ProjectSwift/swift/Eagle Files/SwiftV2.brd

## EAGLE design Eagle Files/SwiftV2.brd (2012-04-03)

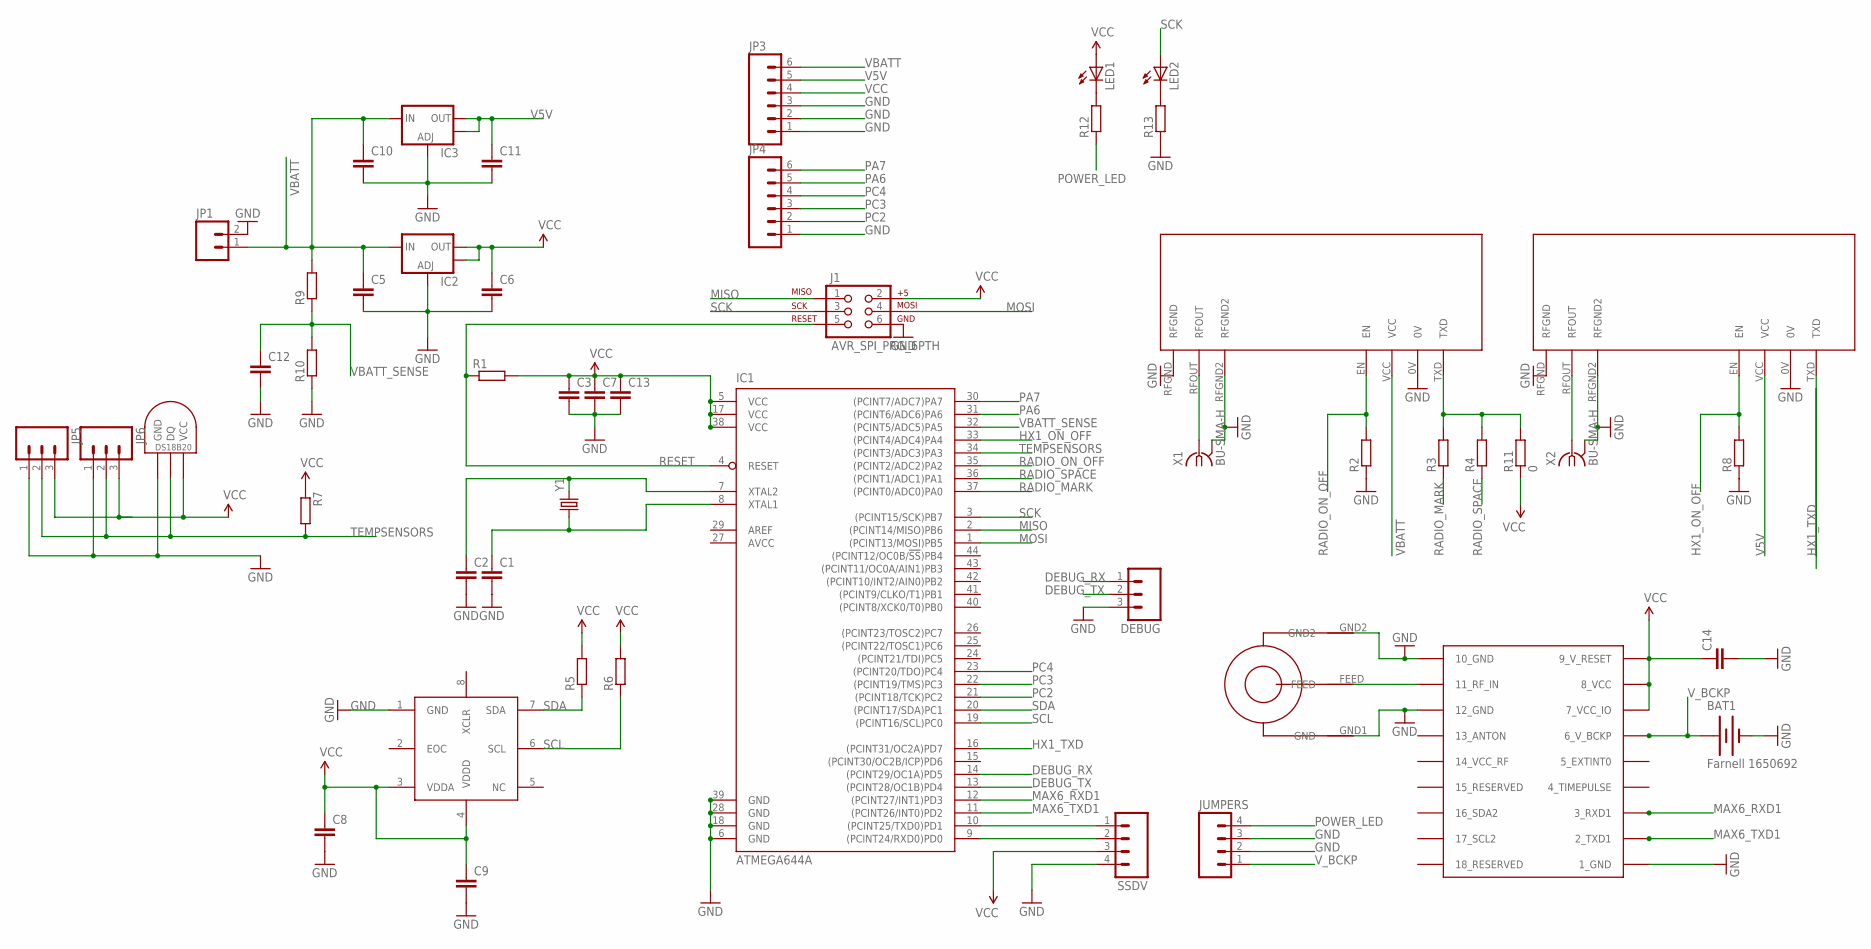
[picture p1: schematic SwiftV2.sch]

Parts:
BAT1: Farnell 1650692; BATTCON_12MM
C1, C2, C3, C5, C6, C7, C8, C9, C10, C11, C12, C13, C14: C-EUC0805; C0805
DEBUG: M03PTH; 1X03
IC1: ATMEGA644A; TQFP44
IC2, IC3: V_REG_LM1117SOT223; SOT223
J1: AVR_SPI_PRG_6PTH; 2X3
JP1: M02JST-PTH-2; JST-2-PTH
JP3, JP4: M06SIP; 1X06
JP5, JP6: M03JST-PTH; JST-3-PTH
JUMPERS: M04PTH; 1X04
LED1, LED2: LED0603; LED-0603
R1, R2, R3, R4, R5, R6, R7, R8, R9, R10, R12, R13: R-EU_R0805; R0805
R11: 0; R0805
SSDV: M04PTH; 1X04
TEMPINT: DS1821; DS18B20_SOIC
U$1: BMP085
U$2: NTX2
U$3: SARANTEL-SR1202
U$4: UBLOX_MAX-6
U$5: RADIOMETRIX-HX1
X1, X2: BU-SMA-H
Y1: CRYSTALSMD; HC49UP

Connections:
AVCC: IC1.27 (AVCC)
DEBUG_RX: DEBUG.1, IC1.14 ((PCINT29/OC1A)PD5)
DEBUG_TX: DEBUG.2, IC1.13 ((PCINT28/OC1B)PD4)
GND: BAT1.GND (-), C1.2, C2.2, C3.2, C5.2, C6.2, C7.2, C8.2, C9.2, C10.2, C11.2, C12.2, C13.2, C14.2, DEBUG.3, IC1.6 (GND), IC1.18 (GND), IC1.28 (GND), IC1.39 (GND), IC2.1 (ADJ), IC3.1 (ADJ), J1.6, JP1.2, JP3.1, JP3.2, JP3.3, JP4.1, JP5.1, JP6.1, JUMPERS.2, JUMPERS.3, R2.1, R8.1, R10.1, R13.1, SSDV.4, TEMPINT.GND, U$1.1 (GND), U$2.0V, U$2.RFGND, U$2.RFGND2, U$3.GND1 (GND), U$3.GND2, U$4.1_GND, U$4.10_GND, U$4.12_GND, U$5.0V, U$5.RFGND, U$5.RFGND2, X1.2 (GND), X1.3 (GND), X1.4 (GND), X1.5 (GND), X2.2 (GND), X2.3 (GND), X2.4 (GND), X2.5 (GND)
HX1_ON_OFF: IC1.33 ((PCINT4/ADC4)PA4), R8.2, U$5.EN
HX1_TXD: IC1.16 ((PCINT31/OC2A)PD7), U$5.TXD
MAX6_RXD1: IC1.12 ((PCINT27/INT1)PD3), U$4.3_RXD1
MAX6_TXD1: IC1.11 ((PCINT26/INT0)PD2), U$4.2_TXD1
MISO: IC1.2 ((PCINT14/MISO)PB6), J1.1
MOSI: IC1.1 ((PCINT13/MOSI)PB5), J1.4
unnamed: C2.1, IC1.7 (XTAL2), Y1.2
unnamed: C1.1, IC1.8 (XTAL1), Y1.1
unnamed: U$2.RFOUT, X1.1
unnamed: LED1.C, R12.2
unnamed: U$5.RFOUT, X2.1
unnamed: U$3.FEED, U$4.11_RF_IN
unnamed: R3.2, R4.2, R11.2, U$2.TXD
unnamed: LED2.C, R13.2
PA6: IC1.31 ((PCINT6/ADC6)PA6), JP4.5
PA7: IC1.30 ((PCINT7/ADC7)PA7), JP4.6
PC2: IC1.21 ((PCINT18/TCK)PC2), JP4.2
PC3: IC1.22 ((PCINT19/TMS)PC3), JP4.3
PC4: IC1.23 ((PCINT20/TDO)PC4), JP4.4
POWER_LED: JUMPERS.4, R12.1
RADIO_MARK: IC1.37 ((PCINT0/ADC0)PA0), R3.1
RADIO_ON_OFF: IC1.35 ((PCINT2/ADC2)PA2), R2.2, U$2.EN
RADIO_SPACE: IC1.36 ((PCINT1/ADC1)PA1), R4.1
RESET: IC1.4 (RESET), J1.5, R1.1
RXD0: IC1.9 ((PCINT24/RXD0)PD0), SSDV.2
SCK: IC1.3 ((PCINT15/SCK)PB7), J1.3, LED2.A
SCL: IC1.19 ((PCINT16/SCL)PC0), R6.1, U$1.6 (SCL)
SDA: IC1.20 ((PCINT17/SDA)PC1), R5.1, U$1.7 (SDA)
TEMPSENSORS: IC1.34 ((PCINT3/ADC3)PA3), JP5.2, JP6.2, R7.2, TEMPINT.DQ
TXD0: IC1.10 ((PCINT25/TXD0)PD1), SSDV.1
V5V: C11.1, IC3.2 (OUT), IC3.4 (OUT), JP3.5, U$5.VCC
VBATT: C5.1, C10.1, IC2.3 (IN), IC3.3 (IN), JP1.1, JP3.6, R9.2, U$2.VCC
VBATT_SENSE: C12.1, IC1.32 ((PCINT5/ADC5)PA5), R9.1, R10.2
VCC: C3.1, C6.1, C7.1, C8.1, C9.1, C13.1, C14.1, IC1.5 (VCC), IC1.17 (VCC), IC1.38 (VCC), IC2.2 (OUT), IC2.4 (OUT), J1.2, JP3.4, JP5.3, JP6.3, LED1.A, R1.2, R5.2, R6.2, R7.1, R11.1, SSDV.3, TEMPINT.VCC, U$1.3 (VDDA), U$1.4 (VDDD), U$4.7_VCC_IO, U$4.8_VCC, U$4.9_V_RESET
V_BCKP: BAT1.PWR@1 (+), JUMPERS.1, U$4.6_V_BCKP

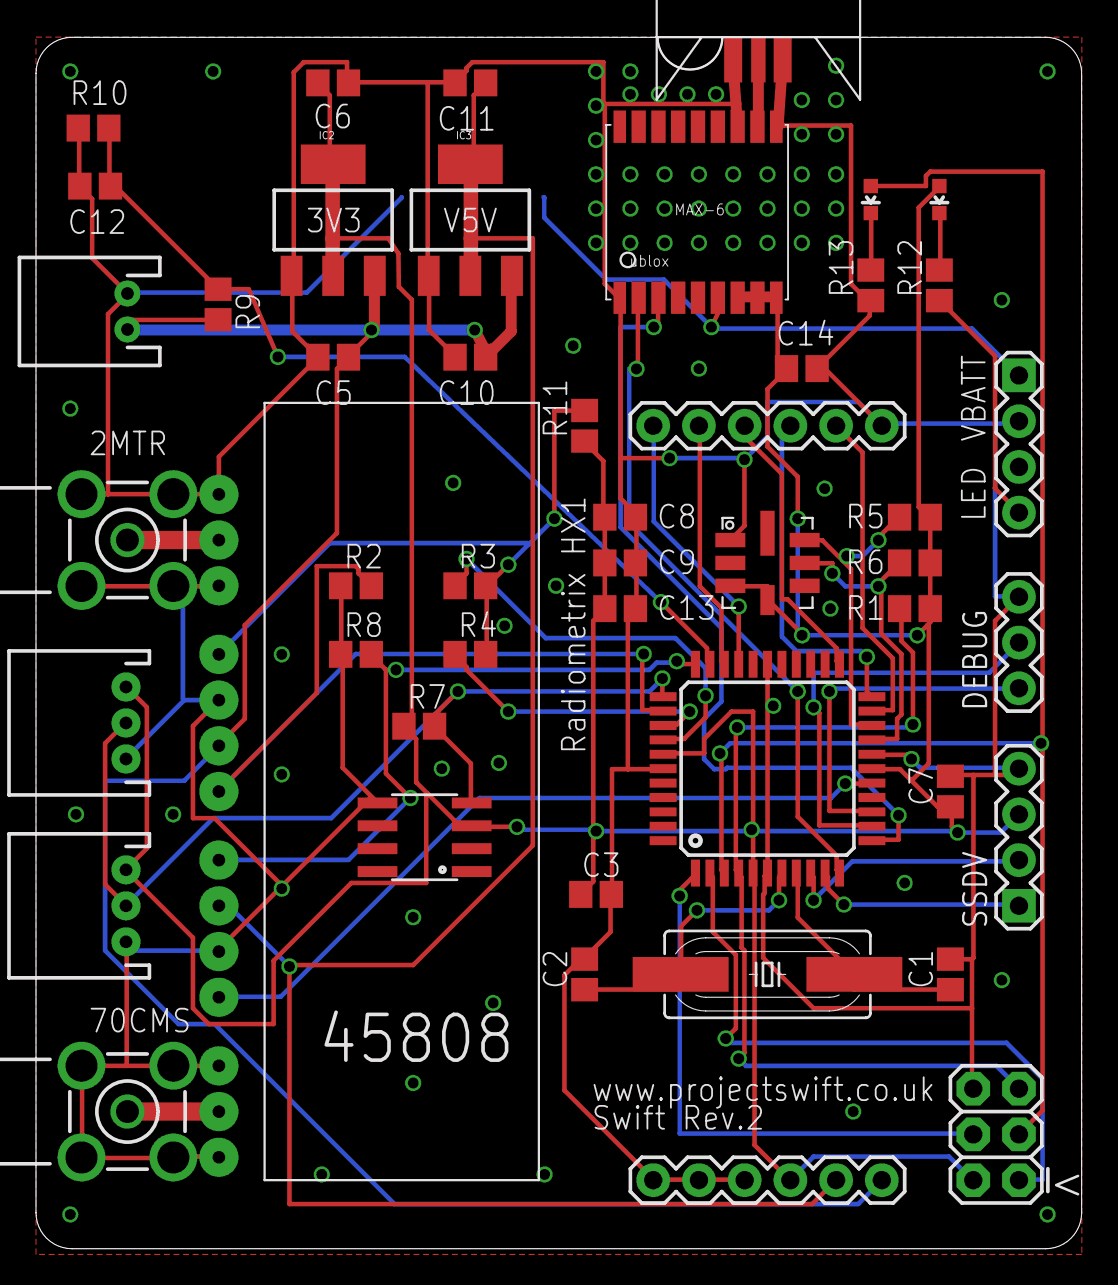
[picture p2: board SwiftV2.brd from above]

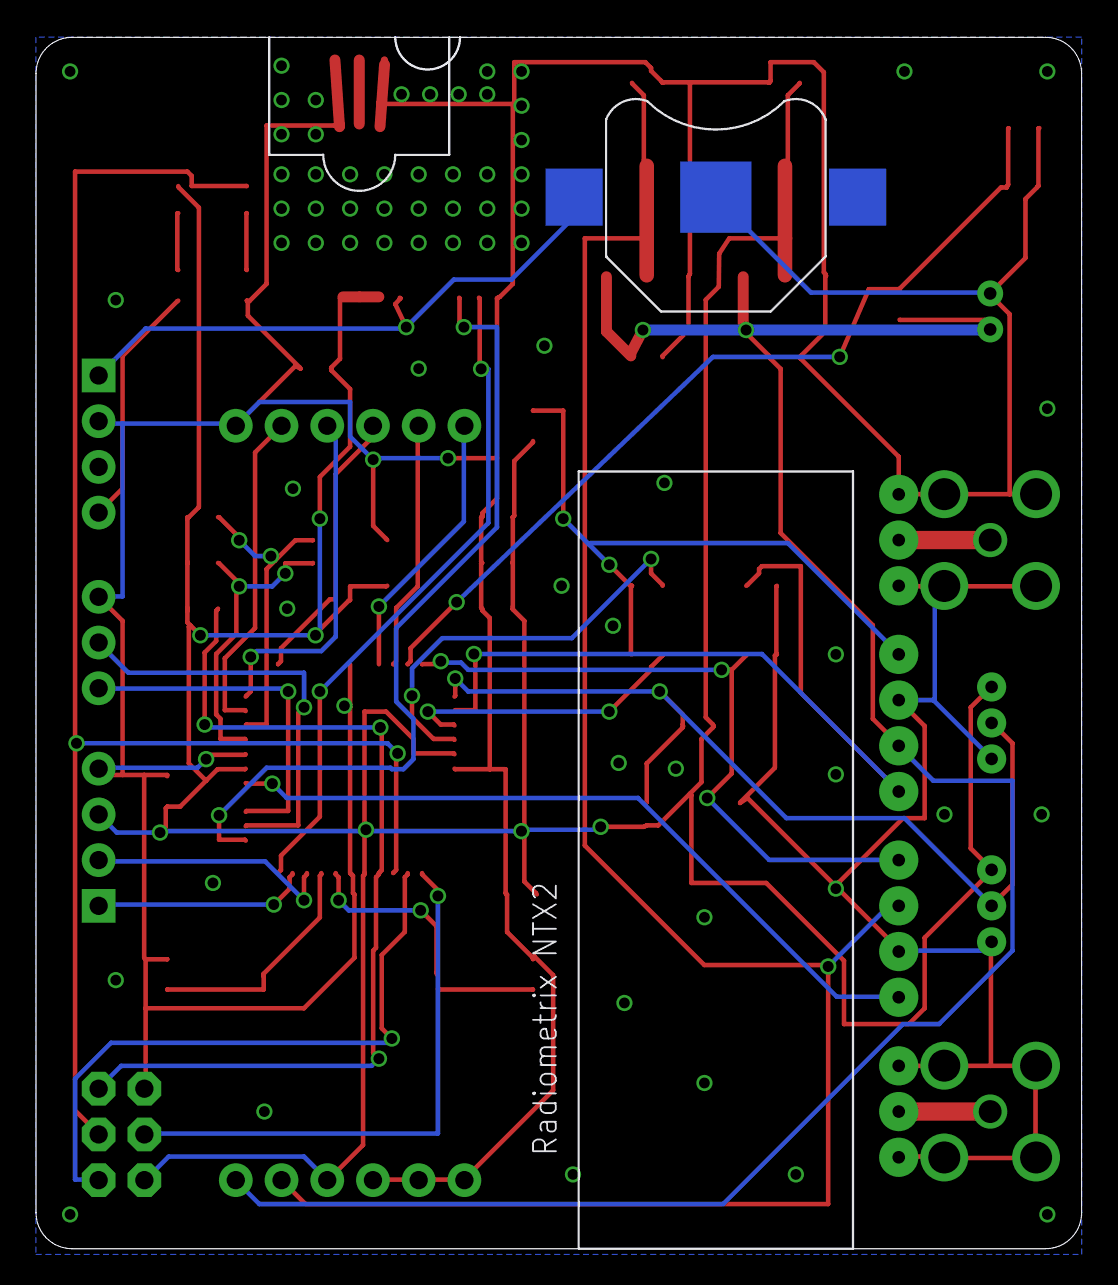
[picture p3: board SwiftV2.brd from below]

Board: 2 copper layers, 58.1 x 67.3 mm, 50 parts (2 on the bottom side), 38 nets.
