ProjectSwift/swift/config.h

#ifndef _CONFIG_H
#define _CONFIG_H

#define F_CPU (8000000)

//#define APRS_ENABLED
#define APRS_CALLSIGN "NOCALL"
#define APRS_SSID     (0)

#define RTTY_CALLSIGN "SWIFT"
#define RTTY_BAUD (300)

//#define SSDV_ENABLED

#endif
