ProjectSwift/swift/geofence.c

/* Project Swift - High altitude balloon flight software                 */
/*=======================================================================*/
/* Copyright 2010-2012 Nigel Smart <nigel@projectswift.co.uk>            */
/* And Philip Heron <phil@sanslogic.co.uk>                               */
/* Additional Help from Jon Sowman & Adam Greig of Cambridge University  */
/* Spaceflight (www.cusf.co.uk)                                          */
/*                                                                       */
/* This program is free software: you can redistribute it and/or modify  */
/* it under the terms of the GNU General Public License as published by  */
/* the Free Software Foundation, either version 3 of the License, or     */
/* (at your option) any later version.                                   */
/*                                                                       */
/* This program is distributed in the hope that it will be useful,       */
/* but WITHOUT ANY WARRANTY; without even the implied warranty of        */
/* MERCHANTABILITY or FITNESS FOR A PARTICULAR PURPOSE. See the          */
/* GNU General Public License for more details.                          */
/*                                                                       */
/* You should have received a copy of the GNU General Public License     */
/* along with this program. If not, see <http://www.gnu.org/licenses/>.  */

#include <stdint.h>
#include <avr/pgmspace.h>

/* The geofence array contains an outline of the area where
 * APRS usage is not permitted */

PROGMEM static const int32_t const geofence[50 * 2] =
{
	489924043, -36103603,
	488138903, -22610257,
	491901282, -13252978,
	496351217, -10050508,
	501037998,  11279993,
	507722758,  16260619,
	513189809,  25152367,
	520765597,  35119373,
	530454023,  42970152,
	539001634,  49909694,
	546830552,  44727668,
	551230292,  34601012,
	554336032,  29904906,
	558418741,  26487290,
	566806014,  24488896,
	575931754,  16723936,
	584164868,  11759240,
	589641150,   4293681,
	601679345,  -5502415,
	602106803, -22911888,
	598068675, -31797350,
	594741753, -52432139,
	590767750,-112927263,
	586042329,-125682437,
	573560679,-123463450,
	568484965,-110679665,
	567960819, -94029714,
	565955176, -84036460,
	562488969, -74621136,
	558888574, -68508447,
	554623831, -62193300,
	554506766, -75560492,
	552283624, -86434228,
	546950633, -86430795,
	539200807, -75704420,
	538233232, -70009827,
	537741074, -59159398,
	534700525, -58290520,
	532493620, -58085376,
	529591630, -58389442,
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
};

static int pointinpoly(const int32_t *poly, int points, int32_t x, int32_t y)
{
	int32_t p0, p1, l0, l1;
	int c = 0;
	
	/* Read the final point */
	p0 = pgm_read_dword(&poly[points * 2 - 2]);
	p1 = pgm_read_dword(&poly[points * 2 - 1]);
	
	for(; points; points--, poly += 2)
	{
		l0 = p0;
		l1 = p1;
		p0 = pgm_read_dword(&poly[0]);
		p1 = pgm_read_dword(&poly[1]);
		
		if(y < p1 && y < l1) continue;
		if(y >= p1 && y >= l1) continue;
		if(x < p0 + (l0 - p0) * (y - p1) / (l1 - p1)) continue;
		
		c = !c;
	}
	
	return(c);
}

int geofence_test(int32_t lat, int32_t lon)
{
	return(pointinpoly(geofence, 50, lat, lon));
}
