ProjectSwift/swift/(commit log)

2012-03-26 Enable RTTY radio on startup, and swap MARK and SPACE to correct pins
    [rtty.c, swift.c]
2012-04-02 Updated README with pin and timer descriptions
2012-04-03 Added Eagle Files For Rev 2
    [SwiftV1.brd, SwiftV1.sch, SwiftV2.brd, SwiftV2.sch]
2012-04-04 Fixed a typo in swift.c
    [swift.c]
2012-04-08 Add code to read the battery voltage
2012-04-10 Add compressed telemetry. Just supply voltage for now
2012-04-15 Add code to search for and query a DS18B20 temperature sensor
2012-04-15 Declare the msg variable static. Fixes bug where first packet of a group was corrupt.
    [ax25modem.c]
2012-05-04 Rename temperature sensor files
2012-05-04 Fixes to the 1-wire code and temperature conversions for DS18S20 sensors
    [ds18x20.c]
2012-05-04 Added temp sensor to telemetry.
2012-05-10 Fetch calibration values automatically if not already loaded
2012-05-10 Add pressure to telemetry data
2012-05-14 Fixes to 1-Wire to enable multiple sensors.
    [diff.txt]
2012-09-29 Add the timer/timeout functions
2012-09-30 Add the SSDV encoder files
2012-10-19 Read the current navmode settings, rather than using a static example
2013-03-12 Print avr-size report after linking
2013-03-12 Send C328 camera command to finish previous image before opening
